uwo-fast/syringe-actuator/cad/main.scad

/**
 * @file main.scad
 * @brief The syringe actuator: the layout, the assembly, and each printed part in its print orientation
 * @author Cameron K. Brooks
 * @copyright 2026
 *
 * The only file that draws. Use the Customizer, or -D:
 *   openscad -D 'part="crank"' -o crank.stl cad/main.scad
 * View > Animate turns the assembly; `angle` sets the start. `report` echoes screws and derived figures.
 *
 * In-line crank-slider: motor shaft vertical, on the syringe axis's line, so crank, rod and plunger
 * move in one horizontal plane. The rod lies on the crank's top face and the clip's tongue, both at
 * axis height; its ends turn on bosses clamped by the pin screws through washers. The clip's sled runs
 * between the frame's rails, which take the rod's side load off the plunger.
 * Numbers in layout() without a derivation are choices, and each says why.
 *
 * Frame of reference: x along the syringe axis, 0 at the flange's rear face, nozzle towards -x;
 * z = 0 at the plate's underside. Crank angle a = 0: pin towards +x, plunger pulled out; a = 180:
 * pushed in. Bought parts are drawn from catalog figures, simplified.
 */

// clang-format off
include <purchased/syringes.scad>;
include <purchased/motors.scad>;
include <parts/frame.scad>;
include <parts/crank.scad>;
include <parts/rod.scad>;
include <parts/clip.scad>;
include <parts/body.scad>;
include <lib/section.scad>;
// clang-format on

// Customizer: one line per setting, so clang-format must leave the dropdown comments whole.
// clang-format off
/* [View] */
part = "assembly"; // [assembly, housed, frame, crank, rod, clip, body, lid, cap, ring_test, report]
syringe = "3ml";   // [1ml, 3ml, 5ml-gnr1, 5ml-gnr2, 10ml, 20ml, 30ml]
motor = "auto";    // [auto, n20, ga25]
angle = 180;       // [0:5:355]
show_bought = true;
section = "none";  // [none, x, y, z]
section_at = 0;    // [-100:1:300]

/* [Print] */
fit = 0.2;   // per side: a printed pocket round bought stock
press = 0.05; // per side: the crank's bore on the steel shaft
hole = 0.1;   // per side: a small hole a screw threads itself into, which prints undersize
wall = 3;     // the frame's walls either side of the flange's slot and past the motor
grip = 0.15;  // per side: how far the clip's lips reach over the push-button; more holds it tighter
ring_grip = 0.5; // per side: how much narrower than the barrel the snap ring's opening is; more holds it tighter
// clang-format on

/* [Hidden] */
$fn = 48;

L = actuator(syringe, motor);

// The assembly bare or in its body, or each printed part turned to how it prints; cut open if asked.
section(section, section_at)
{
    if (part == "assembly" || part == "housed")
        assembly(L, angle + 360 * $t, bought = show_bought, body = part == "housed");
    else if (part == "frame")
        frame(get(L, "frame"));
    else if (part == "crank")
        crank(get(L, "crank"));
    else if (part == "rod")
        rod(get(L, "rod"));
    else if (part == "clip")
        translate([ 0, 0, get(get(L, "clip"), "half_w") ]) clip(get(L, "clip"));
    else if (part == "body")
        let(b = get(L, "body")) rotate([ 0, 90, 0 ]) translate([ -get(b, "x")[1], 0, 0 ]) body(b);
    else if (part == "lid")
        let(b = get(L, "body")) translate([ 0, 0, get(b, "T") + get(b, "wall") + get(b, "lid")[0] ])
            rotate([ 180, 0, 0 ]) lid(b);
    else if (part == "cap")
        let(b = get(L, "body")) rotate([ 0, 90, 0 ]) translate([ -get(b, "x")[1] - get(b, "end_t"), 0, 0 ]) cap(b);
    // the frame's front end alone, its snap ring on a stub of plate: a quick print to try the snap on a syringe
    else if (part == "ring_test")
        let(f = get(L, "frame")) intersection()
        {
            frame(f);
            translate([ get(f, "ring_x") - 1, -100, -1 ]) cube([ get(f, "ring")[1] + 6, 200, 200 ]);
        }
    else if (part == "report")
        report(L);
    else
        assert(false, str("no part '", part, "'"));
}

// ---- Layout

// The layout for a syringe and motor by Customizer name, at the print settings above.
// motor "auto": the motor syringes.scad pairs with the syringe.
// For an adapter in another project: `use <cad/main.scad>`, then front_x(), tip_x(), and the body's
// front_face() and mount_front.
function actuator(syringe,
                  motor = "auto") = let(chosen = syringe_by_name(syringe),
                                        driven = motor_by_name(motor == "auto" ? syringe_motor(syringe) : motor))
    assert(!is_undef(chosen), str("no syringe '", syringe, "'"))
        assert(!is_undef(driven), str("no motor '", motor, "'"))
            layout(syringe = chosen, motor = driven, pin = m3_shcs, pin_washer = m3_washer, fit = fit, press = press,
                   hole = hole, wall = wall, grip = grip, ring_grip = ring_grip);

// The x of the front wall's outer face, the face an adapter meets.
function front_x(L) = let(b = get(L, "body")) get(b, "x")[0] - get(b, "end_t");

// The x of the syringe's front end: the nozzle's, or its luer-lock collar's if that reaches further.
function tip_x(L) = let(s = get(L, "syringe")) - get(s, "flange_t") - get(s, "barrel_l") - get(s, "nozzle_l");

// plate_t: stiff enough over the frame's length.
// pocket: the gearbox's depth into the plate, which locates it square.
// gap: crank underside over the plate, set by the shaft's tip bottoming in the crank's blind bore.
// float: clip underside over the plate.
// clip_wall: the clip's cup; it bears only the stroke on the push-button's rim.
// rod_min: shortest rod, unless the row has crank_as. At least 3 throws, so the rod leans at most
// asin(1/3) = 19.5 degrees.
// rod_w: 2 of wall round a boss's bore. boss_d: the washer overlaps the rod's bore by at least 0.5 a side.
// play: the rod's end float between its seat and the washer.
// sled: [reach past the clip's pin, depth of its top and the rails' under the rod].
// slide: per side, sled between the rails.
// recess: motor screw heads below the plate's top; the motor's row gives its screws and counterbore.
// margin: the stopper stops this short of each end of travel, for error in exposed, stroke and print.
// friction: seal friction, N, assumed, for the report's torque estimate.
// pin_l: pin screw length. window: body window wider than the flanges by this, room for fingers.
// clang-format off
function layout(syringe, motor, pin, pin_washer, fit, press, hole, wall, grip, ring_grip,
                plate_t = 5, pocket = 2, gap = 1, float = 1.5, clip_wall = 2, rod_t = 4, rod_min = 90,
                rod_w = 10, boss_d = 5.6, play = 0.3, sled = [20, 2], slide = 0.3, recess = 0.2,
                margin = 1, pin_l = 10, window = 3.5, friction = 3) =
    let (
        throw = get(syringe, "stroke") / 2 - margin,
        boss = [boss_d, rod_t + play],
        rod_bore = boss_d + 2 * fit,
        tap = get(pin, "tap") + 2 * hole,
        clip = clip_spec(syringe, tap, fit, clip_wall, boss, rod_w, sled, grip),
        button_in = get(syringe, "exposed") + margin,
        // a row's crank_as: another syringe's layout, whose crank this one keeps, by the rod's length
        like = has(syringe, "crank_as")
                   ? layout(get(syringe, "crank_as"), motor, pin, pin_washer, fit, press, hole, wall, grip, ring_grip,
                            plate_t, pocket, gap, float, clip_wall, rod_t, rod_min, rod_w, boss_d, play, sled, slide,
                            recess, margin, pin_l, window, friction)
                                         : undef,
        // the frame and the clip are built from these alone, so a crank_as syringe that matches them reuses both
        differ = is_undef(like) ? []
                                : [for (f = ["barrel_od", "flange", "flange_t", "button_d", "button_t", "plunger_span"])
                                        if (get(get(like, "syringe"), f) != get(syringe, f)) f],
        rod_l = is_undef(like) ? max(rod_min, ceil(3 * throw))
                               : get(like, "crank_x") - button_in - get(clip, "pin_x") - throw,
        axis_z = plate_t + float + get(clip, "half_w"),
        hub_z = plate_t + gap,
        bore = pocket + get(motor, "shaft_l") - hub_z,
        crank = crank_spec(motor, tap, press, throw, axis_z - hub_z, boss, bore, rod_w, m3_set, m3_nut, fit),
        rod = rod_spec(rod_bore, rod_l, rod_t, rod_w),
        crank_x = button_in + get(clip, "pin_x") + rod_l + throw,
        rails = [button_in + 2 * throw + get(clip, "sled_end") + 1, get(clip, "half_w") + slide, axis_z - sled[1]],
        sweep_x = crank_x - throw - rod_w / 2,
        stack = boss[1] + get(pin_washer, "h"),
        pin_tip = axis_z + stack - pin_l,
        mount = get(motor, "mount"),
        motor_screw = mount[0],
        motor_screw_l = mount[1],
        motor_bore = mount[2],
        motor_seat_z = plate_t - motor_bore[1] - recess,
        flat_head = get(motor_screw, "head") == "flat",
        // a flat head seats where its cone matches the clearance hole; other heads sit on the counterbore's floor
        motor_head_z = flat_head ? motor_seat_z + (get(motor_screw, "head_d") - get(motor_screw, "clear") - 2 * fit) / 2
                                 : motor_seat_z,
        // a flat head's length is overall, any other's under its head
        motor_thread = pocket - (motor_head_z - motor_screw_l),
        frame = frame_spec(syringe, motor, motor_screw, fit, wall, plate_t, pocket, axis_z, crank_x, rails, motor_seat_z,
                           motor_bore[0], ring_grip),
        // front mounting holes, spacing across: the narrowest multiple of 10 whose heads clear the snap ring by 0.5
        ring_half = (get(syringe, "barrel_od") + 2 * fit) / 2 + get(frame, "ring")[2],
        mount_w = 10 * ceil(2 * (ring_half + get(pin, "head_d") / 2 + 0.5) / 10),
        // what the frame carries at its extremes over a turn, [y, z], for the body to clear
        reach = throw + rod_w / 2,
        motor_z = pocket - get(motor, "gearbox_l") - get(motor, "can_l") - get(motor, "tail_l"),
        envelope = [
            [reach, hub_z], [reach, axis_z + rod_t],
            [throw + get(pin_washer, "od") / 2, axis_z + stack + get(pin, "head_h")],
            [motor_half_w(motor), motor_z],
            [get(frame, "w") / 2 + get(frame, "dovetail"), 0],
            [get(syringe, "flange")[0] / 2, axis_z + get(syringe, "flange")[1] / 2],
            [get(clip, "half_w"), axis_z + get(clip, "top")],
        ],
        // the same in front of where the rod spreads, which it is checked against separately
        front = [
            [get(frame, "w") / 2 + get(frame, "dovetail"), 0],
            [get(syringe, "flange")[0] / 2, axis_z + get(syringe, "flange")[1] / 2],
            [get(clip, "half_w"), axis_z + get(clip, "top")],
            [get(pin_washer, "od") / 2, axis_z + stack + get(pin, "head_h")],
        ],
        rod_edges = [for (x = [get(frame, "x")[0]:1:crank_x]) [x, rod_edge(x, crank_x, throw, rod_l, rod_w / 2)]],
        body = body_spec(front, concat(envelope, front), rod_edges, crank_x - reach,
                         [get(frame, "x")[0], max(crank_x + reach, get(frame, "x")[1]) + 2],
                         [button_in + 2 * throw + get(clip, "back") + 5, get(syringe, "flange")[0] + window], axis_z, get(syringe, "barrel_od"),
                         [get(frame, "w"), get(frame, "dovetail"), plate_t], get(frame, "x")[1], pin, tap,
                         motor_z + 5, fit, mount_front = [ mount_w, 10, 15 ])
    )
    assert(bore >= 5, str("the shaft reaches only ", bore, " into the crank"))
    assert(rod_l >= ceil(3 * throw), str("the rod is ", rod_l, ", under three throws, to keep the crank of ",
                                         is_undef(like) ? "" : get(get(like, "syringe"), "name")))
    assert(differ == [], str("crank_as names ", is_undef(like) ? "" : get(get(like, "syringe"), "name"),
                             ", which differs in ", differ))
    assert(axis_z - hub_z - bore >= 1.5, "the crank's blind bore leaves under 1.5 over the shaft's tip")
    assert(pin_tip >= hub_z, str("the pin screws reach ", hub_z - pin_tip, " too low: they would drag on the plate"))
    assert(pin_l - stack >= 4, "the pin screws have under 4 of thread")
    assert(get(pin_washer, "od") - rod_bore >= 1, "the washers barely overlap the rod's bores")
    assert(rod_w - rod_bore >= 4, "the rod has under 2 of wall round its bores")
    assert(get(syringe, "barrel_l") > margin + 2 * throw, "the stroke pulls the stopper's face out of the barrel")
    assert(sweep_x - rails[0] >= 1, str("the rails reach ", rails[0] - sweep_x + 1, " into the crank's sweep"))
    assert(sled[1] >= 1, "the sled and the rails are under 1 below the rod")
    assert(get(frame, "w") - motor_size(motor)[1] - 2 * fit >= 3, "the plate is too narrow round the motor's gearbox")
    assert(motor_seat_z - pocket >= 1, "the motor screws' counterbores leave under 1 over the gearbox's pocket")
    assert(motor_thread >= 1.2, str("the motor screws reach only ", motor_thread, " into the gearbox"))
    assert(!has(motor, "hole_depth") || motor_thread <= get(motor, "hole_depth") - 0.5,
           str("the motor screws reach ", motor_thread, " into the gearbox's holes, too near their bottoms"))
    [
        ["name", "layout"], ["syringe", syringe], ["motor", motor], ["pin", pin], ["pin_l", pin_l],
        ["pin_washer", pin_washer], ["motor_screw", motor_screw], ["motor_screw_l", motor_screw_l],
        ["motor_seat_z", motor_seat_z], ["motor_head_z", motor_head_z],
        ["motor_thread", motor_thread], ["friction", friction],
        ["pin_thread", pin_l - stack], ["throw", throw], ["rod_l", rod_l], ["axis_z", axis_z],
        ["pocket", pocket], ["hub_z", hub_z], ["crank_x", crank_x],
        ["frame", frame], ["crank", crank], ["rod", rod], ["clip", clip], ["body", body],
    ];
// clang-format on

// The rod's edge at x, at its widest over a turn: how far it swings off the axis there, plus half its width.
function rod_edge(x, crank_x, throw, rod_l,
                  half_w) = half_w +
                            max([for (a = [0:2:358]) let(p = [ crank_x + throw *cos(a), throw *sin(a) ],
                                                         c = p[0] - sqrt(rod_l * rod_l - p[1] * p[1])) x >= c &&
                                         x <= p[0]
                                     ? abs(p[1]) * (x - c) / (p[0] - c)
                                     : 0]);

// The crank pin's [x, y] at crank angle a.
function crank_pin(L, a) = [ get(L, "crank_x"), 0 ] + get(L, "throw") * [ cos(a), sin(a) ];

// The clip pin's x at crank angle a; it stays on the axis.
function clip_pin_x(L, a) = crank_pin(L, a)[0] - sqrt(pow(get(L, "rod_l"), 2) - pow(crank_pin(L, a)[1], 2));

// ---- Assembly and report

module assembly(L, a, bought = true, body = false)
{
    z = get(L, "axis_z");
    cp = crank_pin(L, a);
    px = clip_pin_x(L, a);
    button_x = px - get(get(L, "clip"), "pin_x");
    color("wheat") frame(get(L, "frame"));
    color("gold") translate([ get(L, "crank_x"), 0, get(L, "hub_z") ]) rotate([ 0, 0, a ]) crank(get(L, "crank"));
    color("mediumseagreen") translate([ px, 0, z ]) rotate([ 0, 0, atan2(cp[1], cp[0] - px) ]) rod(get(L, "rod"));
    color("royalblue") translate([ button_x, 0, z ]) clip(get(L, "clip"));
    if (body)
        color("lightsteelblue", 0.35)
        {
            body(get(L, "body"));
            lid(get(L, "body"));
            cap(get(L, "body"));
        }
    if (body && bought)
        mount_screws(L);
    if (bought)
    {
        translate([ 0, 0, z ]) syringe(get(L, "syringe"), button_x);
        translate([ get(L, "crank_x"), 0, get(L, "pocket") ]) motor(get(L, "motor"));
        screws(L, [ cp, [ px, 0 ] ]);
    }
}

// Pin screws and washers on their bosses at pins [[x, y], ...]; motor screws in their counterbores.
// A pin screw's length is under its head.
module screws(L, pins)
{
    pin = get(L, "pin");
    washer = get(L, "pin_washer");
    ms = get(L, "motor_screw");
    seat = get(L, "axis_z") + get(get(L, "crank"), "boss")[1];
    color("silver") for (p = pins) translate([ p[0], p[1], seat ])
    {
        washer(washer);
        screw(pin, get(L, "pin_l"), get(washer, "h"));
    }
    color("dimgray") for (y = [ -1, 1 ] * get(get(L, "motor"), "hole_pitch") / 2)
        translate([ get(L, "crank_x"), y, get(L, "motor_head_z") ]) if (get(ms, "head") == "flat")
            flat_screw(ms, get(L, "motor_screw_l"));
    else screw(ms, get(L, "motor_screw_l"), 0);
}

// M3 socket heads through the knocked-out mounting holes, heads inside, shown 6 past the body.
// Fit the front ones first. The top ones can go in first too, if the frame slides in with its crank
// along the axis; turned across, the crank's pin screws hit them.
module mount_screws(L)
{
    b = get(L, "body");
    sc = get(b, "screw");
    x = get(b, "x");
    color("silver")
    {
        for (h = get(b, "mount_front"))
            translate([ x[0], h[0], h[1] ]) rotate([ 0, 90, 0 ]) screw(sc, get(b, "end_t") + 6, 0);
        for (h = get(b, "mount_top"))
            translate([ h[0], h[1], get(b, "T") ]) rotate([ 180, 0, 0 ])
                screw(sc, get(b, "wall") + get(b, "lid")[0] + 6, 0);
    }
}

// Echoes what to buy and the derived figures.
module report(L)
{
    f = get(L, "frame");
    throw = get(L, "throw");
    m = get(L, "motor");
    sy = get(L, "syringe");
    echo(str("motor ", get(m, "name")));
    // the crank's peak torque is about the plunger's force times the throw; kg.cm, as gearmotors are rated
    kgcm = throw / 1000 / 0.0980665;
    area = PI * pow(get(sy, "bore_d"), 2) / 4;
    echo(str("torque at the crank, estimated: ", get(L, "friction") * kgcm, " kg.cm on an open line (",
             get(L, "friction"), " N of seal friction, assumed), and ", 0.1 * area * kgcm,
             " more per bar of vacuum or back-pressure; keep it under ", get(m, "torque"), " kg.cm for this motor"));
    echo(str("stroke ", 2 * throw, ", crank throw ", throw, ", rod ", get(L, "rod_l"), ", peak rod angle ",
             asin(throw / get(L, "rod_l")), " deg"));
    echo(str("frame ", get(f, "x")[1] - get(f, "x")[0], " x ", get(f, "w"), ", syringe axis ", get(L, "axis_z"),
             " above its underside"));
    b = get(L, "body");
    echo(str(
        "body ", get(b, "x")[1] - get(b, "x")[0] + 2 * get(b, "end_t"), " long; ",
        [for (sec = [ get(b, "front"), get(b, "back") ])[2 * (sec[0] + get(b, "wall")),
                                                         get(b, "T") + get(b, "lid")[0] - sec[1] + 2 * get(b, "wall")]],
        " wide x high at the front and the back, outside, with the lid"));
    echo(str("screws: 2 x M3 x ", get(L, "pin_l"), " with 2 x M3 washer (crank pin, clip pin), ", get(L, "pin_thread"),
             " of thread; 2 x ", get(get(L, "motor_screw"), "name"), " x ", get(L, "motor_screw_l"), " (motor), ",
             get(L, "motor_thread"), " of it into the gearbox; 2 x M3 x 10 (cap); 1 x M3 x ",
             get(get(L, "crank"), "set_l"), " ", get(get(get(L, "crank"), "set"), "name"), " and 1 x M3 ",
             get(get(get(L, "crank"), "nut"), "name"), " (crank)"));
    mf = get(b, "mount_front");
    mt = get(b, "mount_top");
    echo(str("mounting, knockouts for M3: 4 in the front, ", mf[3][0] - mf[0][0], " across x ", mf[3][1] - mf[0][1],
             " up, centred ", (mf[0][1] + mf[3][1]) / 2, " over the plate's underside, where the syringe's axis is ",
             get(L, "axis_z"), "; 4 in the roof's shoulders, ", mt[3][1] - mt[0][1], " across x ", mt[3][0] - mt[0][0],
             " along, centred ", get(b, "x")[1] - (mt[0][0] + mt[3][0]) / 2, " in front of the back end"));
}
