uwo-fast/syringe-actuator/cad/parts/frame.scad

/**
 * @file frame.scad
 * @brief The frame: a plate holding the syringe at one end and the motor at the other
 * @author Cameron K. Brooks
 * @copyright 2026
 *
 * The barrel's flange drops into a slot, whose walls take the push and the pull, and the barrel
 * snaps into a ring in front of it, past two thin arms. Two rails either side of the clip's travel
 * guide its sled. The motor's gearbox goes up into a pocket under the plate, located by its bushing
 * and held by two screws from above, counterbored under the crank's hub; the motor hangs below the
 * plate. The plate's long edges are dovetails, which the body's rails take when the frame slides
 * in.
 *
 * x along the syringe axis, 0 at the flange's rear face, the nozzle towards -x; z = 0 at the plate's
 * underside. Prints as it stands.
 */

// clang-format off
include <../lib/struct.scad>;
// clang-format on

// axis_z: the syringe axis's height; crank_x: the motor shaft's x. ring: [gap to the flange
// block, length, wall] of the snap ring. ring_grip: per side, how much narrower than the barrel the ring's opening
// is, which the barrel springs its arms open by. ring_root: how far below the axis, in degrees, the base lets go of
// the ring, so each arm bends over a long arc rather than a short one; 45 is the most its underside overhangs.
// chamfer: the motor pocket's mouth. rails: [x of their end, half the gap between them, their top's
// z]; they start at the flange block and reach out to the plate's edges. seat_z: the motor screws'
// heads' seat; screw_bore: the counterbore's diameter over them. dovetail: how far each long edge's foot reaches out,
// at 45 degrees.
// clang-format off
function frame_spec(syringe, motor, screw, fit, wall, plate_t, pocket, axis_z, crank_x, rails, seat_z, screw_bore,
                    ring_grip, ring = [15, 6, 1.6], ring_root = 45, chamfer = 0.5, dovetail = 2.5) =
    let (block = [-get(syringe, "flange_t") - fit - wall, fit + wall],
         ring_x = block[0] - ring[0] - ring[1]) [
        ["name", "frame"], ["syringe", syringe], ["motor", motor], ["screw", screw], ["fit", fit],
        ["plate_t", plate_t], ["pocket", pocket], ["axis_z", axis_z], ["crank_x", crank_x],
        ["ring", ring], ["ring_grip", ring_grip], ["ring_root", ring_root], ["chamfer", chamfer], ["block", block], ["ring_x", ring_x],
        ["rail_end", rails[0]], ["rail_gap", rails[1]], ["rail_top", rails[2]], ["seat_z", seat_z], ["screw_bore", screw_bore], ["dovetail", dovetail],
        ["w", get(syringe, "flange")[0] + 2 * fit],
        ["x", [ring_x, crank_x + motor_size(motor)[0] / 2 + fit + wall]],
    ];
// clang-format on

// A cylinder of diameter d along +x from x = 0 to len, on the syringe axis.
module on_axis(s, d, len) translate([ 0, 0, get(s, "axis_z") ]) rotate([ 0, 90, 0 ]) cylinder(d = d, h = len);

// A slot of width w on the syringe axis, round at the bottom and open to the top, from x = 0 to len.
module u_cut(s, w, len)
{
    on_axis(s, w, len);
    translate([ 0, -w / 2, get(s, "axis_z") ]) cube([ len, w, 100 ]);
}

// The plate's section across the axis, as points: w wide at the top, t thick, its long edges' feet dovetailed out d
// at 45 degrees, each foot standing on a land so its edge is square, not a knife edge. The body's rails take their
// channel from the same points.
function plate_profile(w, d, t, land = 0.6) = [
    [ -w / 2 - d, 0 ], [ w / 2 + d, 0 ], [ w / 2 + d, land ], [ w / 2, d + land ], [ w / 2, t ], [ -w / 2, t ],
    [ -w / 2, d + land ], [ -w / 2 - d, land ]
];

module plate_section(s) polygon(plate_profile(get(s, "w"), get(s, "dovetail"), get(s, "plate_t")));

module frame(s)
{
    sy = get(s, "syringe");
    m = get(s, "motor");
    sc = get(s, "screw");
    fit = get(s, "fit");
    t = get(s, "plate_t");
    z = get(s, "axis_z");
    x = get(s, "x");
    w = get(s, "w");
    block = get(s, "block");
    ring = get(s, "ring");
    ring_x = get(s, "ring_x");
    od = get(sy, "barrel_od") + 2 * fit;
    ring_d = od + 2 * ring[2];
    ft = get(sy, "flange_t");
    slot_h = get(sy, "flange")[1] + 2 * fit;
    cx = get(s, "crank_x");
    chamfer = get(s, "chamfer");
    difference()
    {
        union()
        {
            translate([ x[0], 0, 0 ]) rotate([ 90, 0, 90 ]) linear_extrude(x[1] - x[0]) plate_section(s);
            translate([ block[0], -w / 2, t - 1 ]) cube([ block[1] - block[0], w, z - t + 3 ]);
            // the ring on a base that holds only its bottom, up to ring_root below the axis either side: above that
            // each arm stands free, so the barrel springs it open over a long arc. The corners where the arms leave
            // the base are filleted, so no notch starts a crack there.
            translate([ ring_x, 0, 0 ]) rotate([ 90, 0, 90 ]) linear_extrude(ring[1]) offset(r = -1) offset(delta = 1)
                let(root = [ ring_d / 2 * cos(get(s, "ring_root")), z - ring_d / 2 * sin(get(s, "ring_root")) ])
            {
                translate([ 0, z ]) circle(d = ring_d);
                polygon([ [ -root[0], t - 1 ], [ root[0], t - 1 ], root, [ -root[0], root[1] ] ]);
            }
            // the rails run from the flange block's back wall, out to the plate's edges
            gap = get(s, "rail_gap");
            for (side = [ -1, 1 ])
                translate([ block[1] - 1, side > 0 ? gap : -w / 2, t - 1 ])
                    cube([ get(s, "rail_end") - block[1] + 1, w / 2 - gap, get(s, "rail_top") - t + 1 ]);
        }
        // the flange's slot, open at the sides, then the barrel through the front wall and the plunger
        // through the back
        translate([ -ft - fit, -w / 2 - 1, z - slot_h / 2 ]) cube([ ft + 2 * fit, w + 2, 100 ]);
        translate([ block[0] - 1, 0, 0 ]) u_cut(s, od, -block[0]);
        translate([ fit - 1, 0, 0 ]) u_cut(s, get(sy, "plunger_span") + 2 * fit, block[1] - fit + 2);
        // the snap ring's bore, and its opening, ring_grip a side narrower than the barrel, each tip's top bevelled
        // at 45 degrees as a lead-in so the barrel spreads the arms rather than bearing on their tips
        translate([ ring_x - 1, 0, 0 ]) on_axis(s, od, ring[1] + 2);
        a = get(sy, "barrel_od") / 2 - get(s, "ring_grip");
        h = sqrt(od * od / 4 - a * a);
        translate([ ring_x - 1, 0, 0 ]) rotate([ 90, 0, 90 ]) linear_extrude(ring[1] + 2) polygon(
            [ [ -a, z ], [ a, z ], [ a, z + h ], [ a + 50, z + h + 50 ], [ -a - 50, z + h + 50 ], [ -a, z + h ] ]);
        // the motor: gearbox pocket from below, bushing and shaft through, screws counterbored from above
        translate([ cx, 0, -1 ]) linear_extrude(get(s, "pocket") + 1) motor_outline(m, fit);
        // the pocket's mouth chamfered, against the first layer's squash
        pocket = motor_size(m) + [ 2, 2 ] * fit;
        translate([ cx, 0, -1 ]) linear_extrude(1 + chamfer, scale = [for (p = pocket) p / (p + 2 * chamfer + 2)])
            motor_outline(m, fit + chamfer + 1);
        translate([ cx, 0, -1 ]) cylinder(d = get(m, "bushing_d") + 2 * fit, h = t + 2);
        for (y = [ -1, 1 ] * get(m, "hole_pitch") / 2)
            translate([ cx, y, 0 ])
            {
                translate([ 0, 0, -1 ]) cylinder(d = get(sc, "clear") + 2 * fit, h = t + 2);
                translate([ 0, 0, get(s, "seat_z") ]) cylinder(d = get(s, "screw_bore") + 2 * fit, h = t);
            }
    }
}
