uwo-fast/syringe-actuator/(commit log)

2026-09-30 feat: bootstrap the syringe actuator
    Record the design in docs/design.md: an N20 gearmotor running in one
    direction off a supply turns a printed crank and connecting rod,
    giving a continuous 58 mm stroke on a 3 mL luer syringe with the
    barrel as the only guide. It holds the measured syringe dimensions,
    the N20 inline and worm gearmotor dimensions with their sources, and
    the open items.
    Add the just check/test gates for OpenSCAD source, which grep stderr
    rather than trust the exit code and name themselves as skipped until
    cad/ exists; the STL edge counter; CI with a single ok gate; the
    pre-commit config; and AGENTS.md. Fill in the organization template's
    README, CITATION and licensing table.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
2026-09-30 feat(cad): add the crank-slider prototype parts
    Draw the frame, crank, rod and plunger clip as an in-line crank-slider:
    the N20's shaft stands vertical on the syringe axis's line, so the
    crank, rod and plunger move in one plane. The frame holds the barrel by
    its flanges and a snap ring and hangs the motor under the plate by its
    gearbox face. The crank throw is half the measured 58 mm stroke, and
    the rod is 90 mm, so it leans at most 18.8 degrees.
    layout() asserts the shaft's engagement in the crank, that the shaft
    stays below the rod, that the pin screws clear the plate, and that the
    clip clears the hub. The assembly animates the crank angle, and
    part="report" echoes the screws to buy.
    The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
2026-09-30 feat(cad): size the stroke and slots from the measured plunger
    The syringe's exposed plunger length (10.75 mm, stopper bottomed) and
    its rib span (7.5 mm) replace the nominal figures. The stroke now sits
    1 mm off the barrel's end from the measured length, which moves the
    motor 1.75 mm further out, and the slots for the plunger narrow to
    the measured span.
2026-09-30 fix(cad): turn the rod on bossed pins and stop the crank on its shaft
    A pin screw that clamps the rod either locks the joint, which has to
    turn a full circle every revolution at the crank, or works loose. Each
    rod end now turns on a printed boss 0.3 taller than the rod, and the
    M3 screw clamps an M3 washer down on the boss. The rod is 10 wide for
    2 of wall round the bore.
    The crank's D-bore is blind, so it presses on until the shaft's tip
    bottoms and sits 1 over the plate. It prints upright, a full-depth
    plate with the boss on top. The shaft is 9 long, measured on the motor
    in hand, D-profile over its length.
    The frame's motor pocket gets a 0.5 chamfer at its mouth against the
    first layer'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
2026-09-30 feat(cad): draw the pin and motor screws in the assembly
    The pin screws and washers sit on their bosses and the M1.6 pan heads
    in their counterbores, each drawn at its length from the catalog.
2026-09-30 fix(cad): guide the plunger clip on rails
    On the first print the clip had no guide of its own. On the push stroke
    the rod's side load bowed the plunger sideways and the clip turned with
    it: the plunger cannot carry a side load in compression.
    A sled under the clip now runs 20 past the rod's pin between two rails
    on the frame, 0.3 clear a side. The rails take the side load and keep
    the clip square; the plunger carries only the stroke. Sled and rails
    stay 2 below the rod, and the rails end clear of the crank's sweep,
    which layout() asserts.
2026-09-30 refactor(cad): open the flange slot at the sides and narrow the frame
    The slot's side walls held nothing the front and back walls did not:
    the flanges now drop through a slot open at both sides, and the plate
    is the flanges' width plus the fit, 24.9 instead of 30.9. The rails,
    the snap ring and the motor pocket all fit inside it.
2026-09-30 refactor(cad): run the rails from the flange block to the plate's edges
    Each rail now fills from its guiding face out to the plate's edge, and
    starts at the flange block's back wall instead of just short of the
    clip's travel. The guiding faces and the sled's clearance are
    unchanged.
2026-09-30 feat(cad): colour each printed part in the assembly
    The frame wheat, the crank gold, the rod green and the clip blue, so
    the parts read apart in the assembly view.
2026-09-30 refactor(cad): flare the snap ring's base down to the plate's edges
    The block under the ring was the ring's width with square sides. It now
    curves from the ring's sides at the axis's height down onto the plate's
    top at its edges, tangent at both ends. The ring's top half, which the
    barrel springs open, stands free of it as before.
2026-09-30 refactor(cad): state each fact once and drop dead keys
    - The motor screws' seat height is worked out once in layout(), with
    its 0.2 recess named, and read by the frame's counterbore, the
    screw's thread figure and the drawn screws.
    - The rails are named frame keys; their unused start and the frame's
    unread wall key are gone.
    - clip() reads top and front from its spec instead of recomputing
    them, and bottom is -half_w; the clip's wall is a named choice.
    - The hub assert is dropped, the rails' covers it; a new one holds the
    rod to three throws.
    - Unused opt() and set() leave the struct library; small aliases and
    repeated expressions go.
    No printed geometry changes.
2026-09-30 refactor(cad): fold the layout and the assembly into main.scad
    build.scad and assembly.scad were only ever included by main.scad, so
    they split one file's work across three. main.scad now holds the
    settings, layout(), the assembly view, the report and the part choice;
    catalog.scad keeps the bought parts' figures and their sources, and
    each printed part keeps its own file.
    AGENTS.md describes the new layout, and replaces following another
    project's file structure with the rules this one keeps.
2026-09-30 fix(cad): open the self-tapped pin holes for print shrinkage
    Small printed holes come out undersize, so the M3 pin screws would
    seize cutting their thread in a 2.5 hole. A per-side allowance, hole
    (0.1, in the Customizer), opens them to 2.7. layout() passes the
    crank and the clip that diameter instead of the screw's record, and
    its local for the rod's bore is renamed rod_bore so it no longer
    shares the name.
2026-10-01 feat(cad): house the mechanism in an octagonal body
    The frame's plate gets dovetailed long edges and slides into an
    octagonal tube on two rails, up to a front wall at the snap ring; a cap
    screwed to the back end holds it with a post and lets the motor's wires
    out. layout() collects what the frame carries at its extremes over a
    turn, and the body sizes itself to the smallest octagon that clears
    it, centred below the syringe axis. The syringe loads through a window
    in the roof at any clip position.
    The push-button snaps into the clip's cup past two lips on side walls
    slit free of the end walls, so the syringe stays in whichever way up
    the unit is.
    part="housed" shows the assembly in its body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
2026-10-01 feat(cad): close the body's window with a sliding lid
    The window was open while the unit ran. A lid inside the roof now
    closes it: a channel following the roof's inside, riding on two
    ledges, that slides back under the roof to open as far as the cap, so
    it cannot be lost and the front face stays free for a mount. Its front
    end hangs down to close the slot over the barrel, and a wedge on it
    fits that slot tight only in the last 1.5 of closing (lid_grip, 0.1 a
    side), which holds it shut whichever way up the unit is.
    The body lengthens to about 220 so the lid opens the whole window. The
    roof window no longer cuts the front wall; the barrel's slot does.
2026-10-01 fix(cad): stand the plate's dovetail feet on lands
    Each foot of the plate's dovetailed edges came to a 45 degree knife
    edge, which a 0.4 nozzle cannot print cleanly. It now stands on a 0.6
    land. The profile is a function, plate_profile(), so the body's rails
    can take their channel from the same points.
2026-10-01 feat(cad): fit the body round what it holds
    The octagon was sized for its worst section, the crank's sweep and the
    motor's drop at the back, and carried that size the whole length. The
    body is now a loft of sections fitted to their contents: narrow and
    shallow at the front (about 39 x 34 outside) where there is only the
    syringe, the plate and the clip, tapering from where the rod starts to
    swing to full width and the motor's depth where the crank turns (about
    77 x 64). Each section is square at the top and chamfered at the
    bottom as far as its contents allow; layout() sizes them from the
    extremes over a whole turn and asserts the taper clears the rod.
    With the roof now close over the conten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
2026-10-02 fix(cad): run the cap's post in the frame's rails
    The cap's post was a narrow bar between the rails, pushing on the
    middle of the plate's back edge. It is now the plate's own section, so
    it slides into the same dovetail rails: it squares the cap onto the
    body, bears on the plate's whole back edge, and the rails hold it
    against twisting and lifting.
2026-10-02 fix(cad): end the body's loft at its back station
    Each loft station is a 0.01 slab, and the last one started at its
    station, so the tube ran 0.01 past its back end into the cap. It now
    ends there, and the cap meets the tube face to face.
2026-10-02 docs: record the third print as working
    The third print, body and all, runs as designed at the default
    settings. The README and the design record now say so, the README
    describes the rails and the body instead of the barrel as the only
    guide, mounting is an add-on still to design rather than waiting on a
    working prototype, and the changelog lists the body.
2026-10-03 feat(cad): register the GA25YN370 gearmotor for the larger syringes
    A 25 mm GA25YN370, 12 V 30 rpm, ordered for the 5 to 20 mL syringes.
    The catalog takes its outline from Seeed's JGA25-370 drawing, the same
    form factor, and leaves undef what no source gives for this ratio or
    where the sources disagree: the gearbox's length, the shaft's length
    and the end boss, to measure on arrival.
    The design record gives why: a 20 mL plunger measured on a kitchen
    scale slides at about 2.5 N, 4.9 N pushed hard, so about 0.9 to 1.8
    kg.cm on a 35 mm crank, well within a 25 mm metal gearbox's continuous
    rating and a tenth of this motor's stall. It records the parts
    rejected and the sellers of the same motor.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
2026-10-03 fix(cad): build the clip's lips as exact prisms
    The lips were a polygon extruded sideways. OpenSCAD snaps 2D polygons
    to a grid, so a lip's corners on the side wall land a hair off the
    wall's face whenever the cup's half-width is off that grid. For a
    10.2 mm push-button the corners sit at 5.29999 against the wall's 5.3,
    and the clip exports with 12 edges that do not join two facets. The
    3 mL's 6.5 lands on the grid, so it never showed.
    The lips are now polyhedra from the same points, so their corners land
    exactly. The 3 mL clip's volume is unchanged.
2026-10-03 fix(cad): keep the body's taper within 45 degrees of upright
    The body prints standing on its back, so the inside of its taper, from
    the narrow front to the full back section, is a ceiling as it prints.
    The narrow front ran as far as the rod's swing allowed, and the taper
    got whatever length was left before the crank. That left the 3 mL at
    43 degrees, but a wider flange moves the window back and squeezes the
    taper: a 5 mL body would lean 50 degrees there.
    The narrow front now also stops where the taper would lean past 45
    degrees, so the taper starts sooner. Starting sooner only widens the
    body earlier, so the rod's clearance can only grow. The 3 mL body is
    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
2026-10-03 feat(cad): build for the 1, 3 and 5 mL syringes
    The parts were built for one 3 mL syringe. The catalog now holds the
    1, 3, 5 and 20 mL, measured by hand, and the Customizer's syringe
    choice picks the 1, 3 or 5 mL to build for. The 20 mL is recorded but
    not built: it needs the round 25 mm motor, which the frame does not
    take yet.
    - The rod is three throws long, or 90 mm, whichever is longer, so a
    longer stroke lengthens it instead of failing a check.
    - The body's window is the flange's width plus 3.5 mm.
    - layout() asserts the barrel is longer than the stroke and the margin
    the stopper stops short by, so a stroke that would pull the stopper
    out of the barrel fails the build.
    - The 3 mL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
2026-10-03 feat(build): export one syringe to output/, every syringe to build/
    output/ stays the spot for one-off exports: just export takes the
    syringe to build for, the 3 mL by default. just build writes every
    printed part for every syringe in SYRINGES to build/<syringe>/, which
    is gitignored like output/.
2026-10-03 fix(cad): stop the plunger short of its stop as well as the bottom
    The stopper stopped the margin, 1 mm, short of the barrel's end, but
    the crank then drew it out a full measured stroke from there, which
    left it 1 mm past the plunger's stop at the end of every pull. The
    throw is now half the stroke less the margin, so the stopper stops
    1 mm short of each end, which takes up error in the measured exposed
    length and stroke, and in the print.
    The parts drive 2 mm less: 55.25 mm on the 3 mL, a throw of 27.6 mm.
    The frame, crank, rod and body all shorten with it, so a 3 mL unit
    already printed needs reprinting to get the margin. The design record's
    figures that follow from the throw are updated,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
2026-10-03 feat(cad): set the clip's grip in the Customizer
    How far the clip's lips reach over the push-button, 0.15 mm a side,
    is the one fit that a few tenths of error in a measured push-button
    or in the print can undo: too little and the syringe falls out, too
    much and the button will not go in. It is now a Print setting beside
    fit, press and hole, so a loose or tight clip is fixed by changing a
    number and reprinting the clip. The default is unchanged.
2026-10-03 docs: how to measure a syringe, and what the presets are
    Syringe makers do not publish the dimensions the parts are built from,
    and the same volume differs between makers by most of a millimetre,
    so a user builds for the syringe in hand. docs/measuring.md says what
    each catalog number is, where it is taken, how much an error in it
    matters, and how to take it on soft polypropylene: lengths from a
    flatbed scan with a ruler in it, thicknesses with calipers closed
    lightly. It ends with adding the syringe as an entry and tuning the
    clip's grip.
    The catalog and the design record now say the presets are not BD's:
    the 3 and 5 mL carry no maker's mark, where BD prints its logo at the
    end of the scal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
2026-10-03 fix(test): judge a part from its mesh, whichever OpenSCAD wrote it
    just test read CGAL's volume count from OpenSCAD 2021.01's log, which
    the Manifold backend of later OpenSCADs does not print, so every part
    failed there whatever its geometry. tools/stl_edges.py now counts a
    part's closed shells itself, joining facets only through shared edges,
    so solids apart or touching at a point or an edge, and sealed voids,
    all show as more than one shell, and the gate no longer reads the log
    for a count.
    Manifold keeps coordinates in single precision and writes copies of a
    vertex a few billionths apart, which welding at 0.0001 turned into
    false bad edges. The tool now drops the facets that welding coll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
2026-10-03 feat(cad): add BD's 10, 30 and 50 mL syringes, estimated
    The catalog gains BD Plastipak 10, 30 and 50 mL luer-lock syringes,
    estimated rather than measured: scaled from BD's photo of its range
    against the measured 5 and 20 mL, with outside diameters from
    published figures and exposed lengths from a Terumo pump manual. They
    are good to about a millimetre and are named as estimates, to be
    replaced when one is measured in hand.
    The 10 mL builds on the N20 like the 5 mL: the Customizer's syringe
    choice and just build take it. Its stroke is 69 mm, its rod 104 mm and
    its body 242 mm long, 239 mm tall as it prints. The 30 and 50 mL wait
    on the round 25 mm motor with the 20 mL.
2026-10-03 fix(cad): record the motor screws as the M1.6 x 3 flat heads bought
    The motor screws were modelled as ISO 7045 pan heads, but the ones
    bought and fitted are JIS flat heads, 90 degree countersunk, M1.6 x 3
    (McMaster 91305A002), whose 3 mm is overall, head and all. They sit in
    the counterbore cut for a pan head, their cone on the clearance hole's
    rim, and the printed frame holds the motor with them.
    The counterbore keeps its printed size, now a layout setting of its
    own rather than derived from the screw's head, so the frame is
    unchanged for every syringe. The report names the screw and gives the
    thread it actually puts into the gearbox, 1.4 mm rather than 1.5, and
    the assembly draws the flat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
2026-10-03 refactor(cad): split the catalog into cad/purchased/
    catalog.scad held every bought part's rows, and main.scad drew them.
    Each kind now has a file of rows and a file that draws one:
    syringes.scad and syringe.scad, motors.scad and motor.scad,
    fasteners.scad and fastener.scad. The drawings take their row alone
    and draw at their own origin; the assembly places them.
    syringes.scad also lists the syringes the parts can be built for, by
    the Customizer's names, so main.scad looks the choice up by name
    instead of a chain of tests.
    No geometry changes: every printed part of every syringe and the
    assembly export the same as before.
2026-10-03 feat(test): add just qa, the geometry checks beyond just test
    just test proves each part is one closed solid; it cannot see a part
    that collides with another, a wall too thin to print, or an overhang.
    just qa checks those for every syringe, or the ones named:
    - thin material and thin gaps, under 0.5 mm, in sections of the body,
    lid, cap and frame, printed for review;
    - the body, lid and cap against every moving part at 24 crank angles,
    the syringe dropping in through the fully open lid, and the core
    sliding in from the back; a collision is a shared volume over a
    thousandth of a mm3, so faces that only touch are clear;
    - each printed part's overhangs as it prints.
    It exits 1 on a co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
2026-10-03 feat(build): stamp each export with the commit it came from
    build/ and output/ only change when just build or just export runs, so
    after a change to the source they can hold parts it no longer draws,
    and nothing showed it: a 5 mL body went to the printer from a build
    made before two fixes to its geometry.
    Both now write BUILT_FROM beside the parts: the commit, with -dirty if
    the source had uncommitted edits, the OpenSCAD that made them, the
    syringes, and when. A BUILT_FROM whose commit is not the checkout's
    means the parts are out of date.
2026-10-03 feat(cad): fill the roof's shoulders flush with the lid's rails
    Over the wider back of the body, the lid's rails stood on the roof as
    two free fins, with the roof's shoulders lower either side of them.
    The rails now run out to the shell's sides and are clipped to its
    outline, so the shoulders fill flush with the rails' tops, over the
    back and the taper; the cap's top matches. The rails can no longer
    snap off, and the two long inside corners at their feet, the hardest
    thing on the body to wipe clean, are gone.
    The narrow front is unchanged, the lid slides as before, and the body
    still prints with no overhang past 45 degrees.
2026-10-03 feat(cad): add two four-hole mounting patterns to the body
    The body had no way to be fixed to anything. It now has two
    interfaces, each four M3 clearance holes, for a user's own adapter to
    screw to; the adapters are left to the user, as the syringe's end is.
    - Through the front wall, beside the barrel's slot: 30 across by 10
    up, centred 15 mm over the plate's underside.
    - Through the roof's new shoulders: 60 across by 20 along, centred
    15 mm in front of the back end, behind the crank's sweep.
    Both are the same for every syringe, and the report gives them with
    the syringe's axis height. The screws' heads sit inside: the housed
    assembly draws them, and just qa checks them against every m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
2026-10-03 feat(cad): seal the mounting holes with knockout skins
    The mounting holes went straight through, leaving eight openings in a
    body that is wiped down whether or not it is mounted. Each is now
    blind from inside and stops 0.6 mm short of the outer face, about
    three layers, so the body stays sealed and smooth until a user drills
    or punches through the holes they use; the blind hole guides the drill
    or screw. The skin is a body_spec setting, knockout.
    The front skins print as 3.6 mm bridges at the top of the print, the
    top ones as thin walls. The report and the design record say the
    holes are knockouts.
2026-10-04 feat(cad): widen the front mounting pattern for a wider snap ring
    The front mounting screws' heads sit inside the front wall, beside the
    frame's snap ring round the barrel. At 30 mm across they clear every
    syringe built so far, but a wider barrel's ring would reach them. The
    pattern's spacing across is now the narrowest multiple of 10 whose
    heads clear the ring by 0.5, so it stays 30 for every syringe built
    today, and body_spec stops the build if the holes come within 1.5 of
    the body's sides.
    No geometry changes for the 1, 3, 5 and 10 mL.
2026-10-04 feat(cad): drive the 10, 20 and 30 mL from the GA25 gearmotor
    Vacuum or back-pressure acts on a syringe's bore, which grows fast
    with its size: against a blocked line the N20 suits only the 3 mL, and
    the 10 mL needs the 25 mm GA25. The parts now build for either motor.
    - The GA25's row takes the motor in hand's measurements: gearbox
    25 x 26.8, can 24.3 x 30.8, a centred 4 mm shaft 12.5 from the
    gearbox face with its flat over the last 8, and 1.75 of tail.
    - Each motor row gives its shape, its mounting screws and their
    counterbore, and a torque guide. The frame's pocket, its length and
    the body's room for the motor follow the shape; the GA25 is held by
    two M3 x 4 button heads, 2.85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
2026-10-04 feat(build): let export and qa take a motor other than the default
    A syringe builds for its default motor, but whether a 10 mL runs on an
    N20 is worth printing to find out. just export takes a motor after the
    syringe, as in just export 10ml n20, and writes it into BUILT_FROM;
    tools/qa/qa.sh takes one from MOTOR, as in MOTOR=n20 just qa 10ml.
2026-10-07 fix(cad): hold the crank on the shaft with a grub screw
    The crank was held only by its printed D-bore, keyed by the shaft's
    half-millimetre flat. With the load reversing every stroke, a PETG
    crank on an N20 wore the D round and rode up the shaft within an hour
    (reported 2026-10-05).
    An M3 x 6 set screw (ISO 4026, cup point) now runs back through a lobe
    behind the hub, away from the pin, onto the shaft's flat, which the
    bore turns to face it, through an M3 nut dropped into a slot from the
    crank's top. Steel on steel carries the torque and holds the crank
    down. The screw's length is the longest stock length that stays inside
    the lobe, M3 x 6 on both motors; the hub stays 12 mm across, and the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
2026-10-07 fix(cad): spring the snap ring over long thin arms
    The ring's arms were 2 mm thick and free only above the axis, and its
    opening was 80% of the barrel's width, so each short arm had to bend a
    tenth of the barrel's diameter, 2.1 mm a side on the 20 mL, across its
    layers as printed. In PLA it snapped on every size as the barrel went
    in, worse as the barrel grew and squashed less (reported 2026-10-05).
    - The arms are 1.6 mm thick and stand free from 45 degrees below the
    axis, the most their undersides overhang, so they bend over about
    twice the arc; their roots are filleted.
    - The opening is ring_grip a side narrower than the barrel, 0.5 mm for
    every size, rather than a fraction of it; r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
2026-10-11 feat(cad): give an adapter the front face and the tip to mount to
    Another project mounting the actuator had to restate its front face's
    outline, holes and wall, and measure where the syringe's tip lands, off
    an exported STL. They now come from the layout, with
    use <cad/main.scad>:
    - actuator(syringe, motor) is the layout by Customizer name at the
    print settings in main.scad, which main.scad itself now calls
    - front_face() in body.scad is the front wall's outer face as points,
    the front section grown by the wall up to the lid's lip; the body
    draws its front wall and lip from it
    - front_x() is that face's x, and tip_x() the syringe's front end,
    from a new nozzle_l on each syringe row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
2026-10-16 docs(agents): correct the stack, rendering and layout notes
    AGENTS.md named a sibling repository that is not public, said OpenSCAD
    cannot render a PNG without a display, which it can, and gave 2021.01
    as the only version the gates run on. It now says the gates read the
    exported mesh and pass on 2021.01 and a current nightly alike, says how
    to render and section a part to look at it, and lists cad/lib/.
2026-10-16 docs(design): rewrite the design record for every syringe
    The record grew one print at a time and still described an N20 on a
    3 mL syringe. It now opens with the status and scope as they are: N20
    for the 1, 3 and 5 mL, the GA25 for the 10, 20 and 30 mL.
    - Each part is a short bullet; figures for one syringe say they are
    the 3 mL's, and the report gives any syringe's.
    - The body splits into its shape, the frame and cap, the window and
    lid, mounting, printing and assembly. It stands 211 mm tall for the
    3 mL as it prints, not the 217 the record still said.
    - The motors are one section, the torque estimate in one table.
    - The failures that shaped the design, the unguided clip, the snappin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
2026-10-16 docs(readme): add a guide to building one, and a render
    The README described the project but not how to make one. It now
    shows the mechanism and walks through picking a syringe, exporting the
    parts, the hardware to buy for either motor, printing, assembly,
    tuning the clip and ring, and mounting, and lists tools/ in the
    layout.
2026-10-16 docs: bring the changelog, citation and licensing up to date
    The changelog listed only the first N20 build; it now covers the
    syringe presets, the GA25, the mounting patterns, the new checks and
    the fixes since. The citation's abstract covers 1 to 30 mL on either
    motor, and LICENSING.md names tools/ with the other build tooling.
    # Conflicts:
    # CHANGELOG.md
2026-10-16 docs(cad): reflow the layout's and the parts' comments
    The comment over layout()'s parameters and the frame's and clip's
    headers had been patched until their lines broke mid-sentence. They
    are rewrapped, and the Customizer's wall setting, the only one without
    a comment, gains one. No geometry changes.
    # cad/main.scad
    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
2026-10-16 fix(cad): let section_at cut a whole body
    The Customizer's section_at slider ran from -100 to 100, but the
    bodies reach 260 mm along the axis, so it could not cut open the back
    of a large one. It now runs to 300.
2026-10-16 docs(cad): drop the syringes' note that the 20 mL is not built
    The comment over the syringe rows still said the 20 mL waits on a
    frame for the round motor, which it has had since the GA25 landed, and
    had been patched until its lines broke mid-sentence. It is rewrapped
    without that sentence.
2026-10-16 docs: describe the mounting interface and nozzle_l
    actuator(), front_x(), tip_x() and the body's front_face() let an
    adapter drawn in OpenSCAD take the actuator's numbers with
    use <cad/main.scad>, but only the changelog said so. The README's
    mounting step and the design record's mounting bullet now show how,
    the measuring guide lists nozzle_l, and the syringe table gives it:
    derived for the 5 mL, not measured for the rest.
    The README's example runs on OpenSCAD 2021.01 and a 2026.10.03 nightly
    alike: front_x is -29.2 for the 3 mL, and tip_x -75.1 for the 5 mL.
2026-10-16 docs: correct figures and steps that did not match the CAD
    - The README's assembly put the crank on before the motor, which can't
    be done: the crank's hub covers the motor's screws. The motor goes on
    first, the front mounting screws before the frame, and step 4 warns
    that the body needs a tall printer.
    - The front mounting pattern is not 30 across for every syringe up to
    the 10 mL: it is the narrowest multiple of 10 that clears the snap
    ring, 20 for the 1 mL. The design record and body.scad now say so.
    - The motor table gains the 1 mL, the N20 suits the 1 and 3 mL against
    vacuum, not the 3 mL alone, and the record says the report assumes 3
    N of friction throughout, less than th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
2026-10-16 docs: give the motor-first reason that holds for both motors
    The crank's hub covers the N20's screws but only the edge of the
    GA25's; the motor goes on first on both because its shaft comes up
    through the plate. Against vacuum the 3 mL needs 2.53 kg.cm, right at
    the N20's 2.5, and the design record now says so. Two of the README's
    steps are rewrapped.
2026-11-02 feat(render): draw pictures of the actuator from a list of views (#14)
    * feat(render): draw pictures of the actuator from a list of views
    `just render` draws the rows of cad/views.tsv to PNGs in
    output/figures/<syringe>/: a name, a syringe, a view and the -D
    settings main.scad's Customizer already offers. A glob draws some of
    them, and a syringe argument replaces every row's own.
    `just render-parts <syringe>` draws every part in PARTS on its own,
    in its print orientation, so a new part needs no row.
    The list starts with the mechanism from five sides, one stroke from
    above at four crank angles, the body whole and cut along the syringe,
    and the GA25 build on the 10 mL.
    Every view is orthogr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
2026-11-08 feat(cad): add a second generic 5 mL syringe
    The new generic matches the first across the axis and is shorter:
    stroke 47.3 against 52.5, exposed 13.6 against 14.3, barrel 56.8
    against 63.5. On a unit printed for the first, the old crank would
    drive its plunger 4.9 mm past the stop.
    An optional rod_min on a syringe row sets that row's shortest rod. A
    93.3 mm rod keeps the crank at the first syringe's 140.55 mm, so the
    printed unit takes the new syringe with a new crank and rod, 7.6 cm3.
    Between the two presets the clip's .csg is identical and the frame's
    differs only in rail length, 94.6 against 88.7 mm. The body, lid and
    cap are larger for the first (body 210.8 against 201.8 mm long).
    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
2026-11-08 fix(cad): derive the second 5 mL's rod from the first's crank
    rod_min 93.3 restated a figure that follows from the first 5 mL's row:
    re-measure that row's exposed from 14.3 to 14.8 and its crank moves
    to 141.05 while the second's stayed at 140.55, with every gate green.
    A row's crank_as now names the syringe whose crank position it keeps,
    layout() derives the rod from it, and the build stops unless the two
    share the axis's height and the frame's width. With the same mutation
    the second's rod follows to 93.8; with the second's button_d at 18.0
    the build stops. The rod is still 93.3, and every part of all seven
    presets exports to the same .csg as before.
    The syringe rows' comment again gives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
2026-11-08 fix(cad): check crank_as against every cross-section figure
    The crank_as check compared only the axis's height and the frame's
    width, so a second syringe with a thicker push-button built cleanly
    though the first's clip would not take it. It now compares barrel_od,
    flange, flange_t, button_d, button_t and plunger_span, which the frame
    and clip are built from, and names the ones that differ: the second
    5 mL's button_t at 2.2, or its button_d at 18.0, stops the build.
    The recursive layout() call now forwards every parameter. A caller
    that set rod_min = 100 got 150.55 for the first syringe's crank and
    140.55 for the second's; both are now 150.55.
    The torque table gives the second 5 mL its own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
2026-11-14 docs(cad): shorten the comments to one item per line
    The comments ran as long paragraphs; each parameter, source and rule
    now gets its own short line. Every source, date and figure stays.
    No code line changed: every part and the report for all seven presets
    export to the same .csg and echo the same figures as before (77 of
    77), and just check passes.
